fammad/lumen/archive/lumen-nordichi2026-extended-abstract.pdf

## Lumen: A Tangible Somaesthetic Peripheral for Negotiated Screen-Work Interruption

FUAD MAMMADOV, (https://orcid.org/0009-0003-7898-0205) KTH Royal Institute of Technology, Sweden

YUTING CHEN, (https://orcid.org/0000-0003-3098-0639) KTH Royal Institute of Technology, Sweden

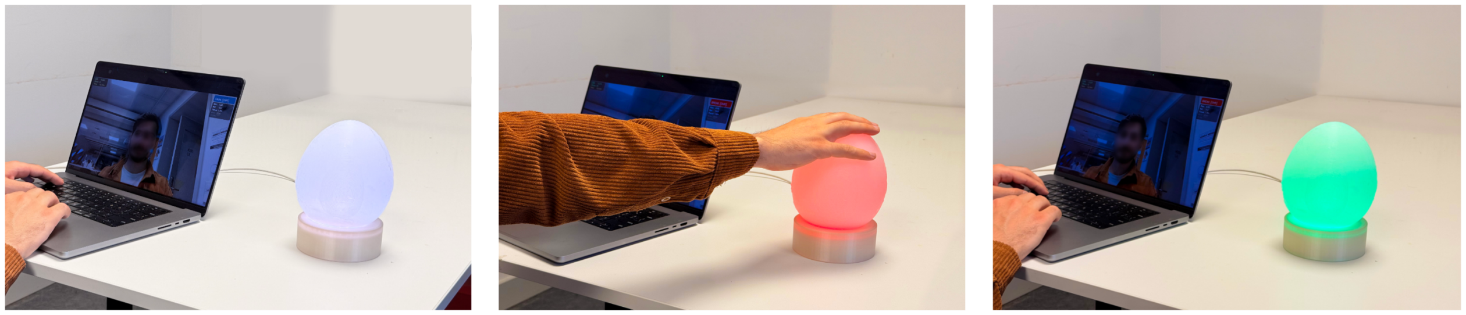
[picture p1: figure]

Fig. 1. Lumen in three states from left to right: calm (deep white pulsing), break (deep red pulsing), and rest (deep green pulsing after user tap) states.

Interruption coordination is a longstanding HCI concern, yet many deployed systems rely on immediate interruption: system-timed prompts that demand focal attention regardless of the user’s attentional or bodily state. A somaesthetic alternative is needed that signals attentional state change while preserving the user’s agency to respond. In this demo, we present Lumen, a tangible peripheral object designed as an instance of negotiated interruption. Lumen is a hand-cast translucent silicone dome that sits on the desk and pulses in response to the body’s blink rhythm via a webcam using the Eye Aspect Ratio method. Three ambient breathing states are rendered through variations in light rhythm and color, reflecting different blink-derived attentional needs. Designed through a soma-informed iterative process, the interaction aims to remain subtle, peripheral, and bodily perceivable rather than an explicit notification. An exploratory showcase with five participants suggested that the interaction was perceived as bodily evocative and identified the legibility of the negotiation gesture as a emerging design concern for future ambient interaction research.

Additional Key Words and Phrases: Negotiated interruption, Tangible interaction, Peripheral ambient display, Ambient light, Blink rate sensing, Somaesthetic design

ACM Reference Format:
Fuad Mammadov and Yuting Chen. 2026. Lumen: A Tangible Somaesthetic Peripheral for Negotiated Screen-Work Interruption. In Proceedings of NordiCHI 2026 (NordiCHI ’26). ACM, New York, NY, USA, 3 pages. https://doi.org/XXXXXXX.XXXXXXX

### 1 Introduction

Sustained screen work suppresses the involuntary blinking rhythm of the body: a healthy rate of 15–20 blinks per minute drops to 4-5 during focused work [8], which contributes to the symptoms of Computer Vision Syndrome, affecting up to 69% of screen users [1]. Prevailing digital wellbeing tools, such as Pomodoro timers, notification chimes, and screen-freeze applications, respond to this somatic condition by overriding it. McFarlane’s taxonomy [7] distinguishes immediate interruption from negotiated interruption, in which the system signals state while preserving the user’s

Authors’ Contact Information: Fuad Mammadov, (https://orcid.org/0009-0003-7898-0205) fuadm@kth.se, KTH Royal Institute of Technology, Stockholm, Sweden; Yuting Chen, (https://orcid.org/0000-0003-3098-0639) yutingch@kth.se, KTH Royal Institute of Technology, Stockholm, Sweden.

2026. Manuscript submitted to ACM

Manuscript submitted to ACM | 1

2 | Mammadov and Chen

agency to respond. Inspired by the negotiated interruption, we designed a peripheral desktop artifact for negotiating screen-work breaks through ambient light rhythms and simple touch interaction. Using the first-person perspective and soma design methods, we treated blink-derived bodily rhythms as a dynamic design material for shaping the temporal behaviors of an interactive physical artifact, to explore how subtle temporal light behaviors may support non-prescriptive attentional awareness. We further conducted an exploratory showcase with five participants to gather initial reflections on the artifact’s embodied qualities.

### 2 Lumen

Lumen is a hand-cast translucent silicone dome, that sits on the user’s desk and glows. It uses webcam-based blink detection (MediaPipe Face Mesh and the Eye Aspect Ratio (EAR) method [9]) to estimate the user’s normal blink frequency, and sense prolonged blink suppression, without storing video and connecting to the network. These changes are mapped onto four ambient breathing light behaviors corresponding to different needs for attentional disengagement: stable blinking, reduced but sustainable blinking, prolonged blink suppression, and during rest. We iteratively designed and experienced four corresponding Lumen breathing behaviors as: a slow white breathing light that remains unnoticeable, a slightly faster but still peripheral white breathing light, a red breathing rhythm intended to evoke attentional awareness and mild concern, and a slow green breathing light associated with rest and interaction. An embedded force sensor supports simple, passive, and embodied interactions activated by sustained holding and gentle tapping, allowing users to negotiate transitions between concentrated work and rest.
| In the design of Lumen, Soma Design [4] was used as a primary approach to explore how blink-derived bodily
rhythms could be expressed through dynamic light behaviors and physical form. Through first-person design inquiry, iterative decisions regarding materiality, interaction, and ambient light behavior were guided by felt bodily experience. The final artifact further draws on concepts from graduated soft interruption [3], ambient-display notification levels [6], tangible interaction [5], and slow technology [2].

### 3 Reflections and Future Works

Small-scale exploratory evaluations were conducted, including a four-week autoethnographic study, iterative design of light behaviors, informal feedback with colleagues, and a 90-minute showcase with five participants. During the iterative design process, a range of light behaviors was experienced and reflected upon, including asymmetric breathing, stochastic peak brightness, variations in breathing rhythm, brief color shifts during breathing, laggy brightness effects, and subtle jitter. Our somatic feedback guided the iterative design and refinement processes toward perceptually salient yet non-intrusive patterns. Through these exploratory studies, we found that: (1) participants preferred slow, symmetric, and non-colored breathing pulses in screen-focused contexts; (2) complex temporal dynamics were less noticeable than color changes, and colored lights (e.g., red and green) were strongly associated with symbolic meanings such as traffic signals; (3) one participant described the system as “a living organism,” and outside screen-focused work contexts, participants expressed interest in richer embodied interactions (e.g., stroking, lifting and replacing, or two-hands embracing). These findings are exploratory and suggest directions for future structured lab and in-situ studies on attention and embodied light aesthetics.

### 4 Acknowledgements

The authors thank the five participants in the showcase session for their insightful feedback, and the peer researchers in the Interactive Media Technology programme at KTH for their critiques across multiple iteration cycles.

Manuscript submitted to ACM

Lumen: A Tangible Somaesthetic Peripheral for Negotiated Screen-Work Interruption | 3

### 5 Generative AI Disclosure

The authors used large language models (Claude by Anthropic and ChatGPT by OpenAI) and Grammarly Pro to paraphrase and improve the clarity of selected sentences. All research ideas, design decisions, fabrication, code, and conclusions are solely the authors’ own.

References

[1] Clayton Blehm, Seema Vishnu, Ashbala Khattak, Shrabanee Mitra, and Richard W. Yee. 2005. Computer vision syndrome: a review. Survey of Ophthalmology 50, 3 (2005), 253–262. doi:10.1016/j.survophthal.2005.02.008 (https://doi.org/10.1016/j.survophthal.2005.02.008)
[2] Lars Hallnäs and Johan Redström. 2001. Slow Technology – Designing for Reflection. Personal and Ubiquitous Computing 5, 3 (Jan. 2001), 201–212. doi:10.1007/PL00000019 (https://doi.org/10.1007/PL00000019)
[3] Joyce Ho and Stephen S. Intille. 2005. Using context-aware computing to reduce the perceived burden of interruptions from mobile devices. In Proceedings of the SIGCHI Conference on Human Factors in Computing Systems (CHI ’05). Association for Computing Machinery, New York, NY, USA, 909–918. doi:10.1145/1054972.1055100 (https://doi.org/10.1145/1054972.1055100)
[4] Kristina Höök. 2018. Designing with the Body: Somaesthetic Interaction Design. MIT Press, Cambridge, MA, USA. doi:10.7551/mitpress/11481.001.0001 (https://doi.org/10.7551/mitpress/11481.001.0001)
[5] Hiroshi Ishii and Brygg Ullmer. 1997. Tangible bits: towards seamless interfaces between people, bits and atoms. In Proceedings of the ACM SIGCHI Conference on Human factors in computing systems (CHI ’97). Association for Computing Machinery, New York, NY, USA, 234–241. doi:10.1145/ 258549.258715 (https://doi.org/10.1145/258549.258715)
[6] Tara Matthews, Anind K. Dey, Jennifer Mankoff, Scott Carter, and Tye Rattenbury. 2004. A toolkit for managing user attention in peripheral displays. In Proceedings of the 17th annual ACM symposium on User interface software and technology (UIST ’04). Association for Computing Machinery, New York, NY, USA, 247–256. doi:10.1145/1029632.1029676 (https://doi.org/10.1145/1029632.1029676)
[7] Daniel McFarlane. 2002. Comparison of four primary methods for coordinating the interruption of people in human-computer interaction. Human-Computer Interaction 17, 1 (March 2002), 63–139. doi:10.1207/S15327051HCI1701_2 (https://doi.org/10.1207/S15327051HCI1701_2)
[8] Mark Rosenfield. 2011. Computer vision syndrome: a review of ocular causes and potential treatments. Ophthalmic & Physiological Optics: The Journal of the British College of Ophthalmic Opticians 31, 5 (Sept. 2011), 502–515. doi:10.1111/j.1475-1313.2011.00834.x (https://doi.org/10.1111/j.1475-1313.2011.00834.x)
[9] Tereza Soukupova and Jan Cech. 2016. Eye blink detection using facial landmarks. In 21st computer vision winter workshop, Rimske Toplice, Slovenia, Vol. 2. Czech Technical University in Prague, Prague, Czech Republic, 4. https://cmp.felk.cvut.cz/ftp/articles/cech/Soukupova-TR-2016-05.pdf

Manuscript submitted to ACM
